rural666/xianguang-fpga-instrument/设计说明与生成脚本/弦光_界面设计说明.md

# 弦光 · 演奏界面设计说明（800×480）

配套文件：

| 文件 | 内容 |
| --- | --- |
| `xianguang_v6.html` | 设计源文件。直接打开是待机画面，网址后加 `#play` 是演奏画面 |
| `弦光_v6_待机_800x480.png` | 待机状态定稿 |
| `弦光_v6_演奏_800x480.png` | 演奏状态定稿（示例和弦 F 大七和弦） |
| `xianguang_v5.html` / `弦光_v5_*.png` | 上一版（正弦波振动），保留作对比 |

---

## 一、设计理念

### 1. 名字就是画面

"弦光"两个字本身就是设计方案：一根弦，发光。所以画面正中横着一根弦，它就是产品的名字，也是画面里唯一的视觉符号。不做和名字无关的装饰——这也是上一版（v3）的问题：那版的角标、内框、镂空数字、开关、音量柱，每一项单看都成立，合起来却是一套可以套在任何产品上的通用黑金模板，跟"弦光"没有关系。

### 2. 一个焦点，其余全部退让

整幅画面只有两个亮的东西：**弦**，和**被按下的琴键**。标题、参数、琴键音名都用暖灰，明度刻意压低。观众第一眼看弦，第二眼看琴键，不需要第三眼。

判断标准：如果一个元素去掉之后画面没有变差，它就不该存在。v3 到 v4 删掉的东西比增加的多，这是刻意的。

### 3. 金色是贵金属

金色（`#d8bd86`）只出现在三个地方：弦、和弦音名、按下的琴键。其余全部是暖灰的四个明度层。金色一旦铺开——标签是金色、数字是金色、键帽是金色——它就不再值钱，画面也就失去了贵气。稀缺性是高级感最便宜的来源。

### 4. 层次来自排版，不来自装饰

不用分割框、不用色块、不用阴影卡片来区分区块，而是用**字号差**和**字距差**：

- 主角"柔和钢琴"58px 极细宋体
- 参数值 38px Bodoni 数字
- 标签 10.5px，字距 .28em
- 英文小字 9.5px，字距 .42em

字号从 58 到 9.5 跨了六倍，主次自然分明。字号差距拉大，装饰就可以全部删掉。

### 5. 用物理真实代替电子特效

振动特效做两版，是这份设计里最重要的一次判断：

- **v5（弃用）**：正弦折线。线条尖锐、起伏均匀地铺满整条弦，整条线一起抖。这是示波器、频谱条、音乐播放器的视觉语言——是"电子特效"，不是"弦"。
- **v6（采用）**：**长曝光下的一根振动弦**。真实的琴弦振动，用长曝光拍出来是柔和的"光茧"：弦在振幅两端停留时间最长，所以光茧**边缘最亮、中间通透**。被拨动的位置是一个主光茧，两侧各有一个逐渐变小的光茧（驻波节点）。

高级感的来源不是更复杂的算法，而是**换一个参照物**：从"电子设备的显示"换成"摄影和乐器本身的物理"。凡是能用真实物理现象解释的效果，都比凭空设计的特效更耐看。

### 6. 因果链必须成立

光丝从弦上垂下来，落在对应的琴键上，琴键**顶端**被这道光照亮（暖色从键顶往下衰减）。这样"手指按下 → 琴键 → 弦 → 光"是一条完整的因果链，而不是两块各自发光的装饰。做界面时反复问：这个光是从哪来的？如果答不上来，就是特效不是设计。

### 7. 待机要安静

待机画面是那根**一动不动**的弦，中间一个很淡的光点，然后是"按下琴键，开始演奏"。不闪烁、不呼吸、不放待机动画。安静本身就是高级感——产品一直在那里等着，不需要证明自己醒着。

### 8. 像素级节制

- 线一律 1px，不加 2px 边框
- 圆角只用在琴键（3px）和状态点，标题、面板、边角全部直角
- 不用发光滤镜做大面积光晕，光只出现在弦和被按的键上
- 加一层极淡的胶片颗粒（6% 不透明度，overlay 混合），消除纯色渐变的数码感

这几条都是为了让画面在 800×480 这个尺寸下不显廉价：小屏上任何一处"厚"一点，整体都会塌。

---

## 二、色彩

只有四个暖灰明度层 + 一个金色 + 一个点缀红。

| Token | HEX | 用途 | FPGA 颜色字面量 |
| --- | --- | --- | --- |
| 底 | `#0c0b0a` | 页面底色 | `24'h0c0b0a` |
| 底·渐变 | `#0e0d0c` → `#0b0a09` | 竖直渐变 | `24'h0e0d0c` / `24'h0b0a09` |
| 柔光 | `rgba(216,189,134,.10)` | 弦后 420×120 径向光 | — |
| 主文字 | `#ebe5d9` | 品牌、参数值、状态 | `24'hebe5d9` |
| 标题 | `#f2ede3` | "柔和钢琴" | `24'hf2ede3` |
| 次文字 | `#a39b8d` | 提示语、键位、音量刻度 | `24'ha39b8d` |
| 弱文字 | `#6e675d` | 标签、英文小字 | `24'h6e675d` |
| 极弱 | `#3a3631` | 状态分隔线 | `24'h3a3631` |
| **金** | `#d8bd86` | 弦、和弦音名、按下琴键 | `24'hd8bd86` |
| 金·亮 | `#f6e4bb` | 弦的芯线、光点 | `24'hf6e4bb` |
| 红 | `#c0392b` | "实时演奏"指示点 | `24'hc0392b` |
| 毡条 | `#4a1517` | 琴键上方防尘毡 | `24'h4a1517` |

金色只允许出现在上表标注"金"的三处，其他任何地方用金色都是错的。

---

## 三、字体

| 用途 | 字体栈 | 字号 | 字距 |
| --- | --- | --- | --- |
| 标题「柔和钢琴」 | Noto Serif SC ExtraLight | 58px | .04em |
| 参数值（100 / 4） | Bodoni MT | 38px | 0 |
| 「关闭」 | Noto Serif SC Light | 25px | .08em |
| 标签（音量/八度/姿态） | Noto Serif SC | 10.5px | .28em |
| 品牌「弦光」 | Noto Serif SC | 17px | .24em |
| 英文小字 | Garamond | 9.5px | .42em |
| 音名（C4 / F♯4） | Bodoni MT | 13.5 / 9.5px | 0 |
| 键位（A / W） | Garamond | 9.5 / 8.5px | .06em |

**落到 HDMI 上要注意**：现在工程里 `assets/font8x16.hex` 是 8×16 点阵，只能满足小字级；标题 58px 需要另做点阵。

建议：

- 标签、键位、底栏继续用现成的 8×16 字模
- 标题「柔和钢琴」单独做一套 56×56 或 64×64 点阵（4 个汉字 1bpp = 56×56×4/8 = 1568 字节，很小）
- 参数值 100 / 4 用 32×48 数字点阵，10 个字形
- 「音色」「音量」「八度」「姿态」「关闭」「空间 · 开」等固定文案已经烘焙在 `assets/scene_text.hex`（1840 字节，纯 ASCII 文本 ROM），需要按新排版重新生成

---

## 四、版面（800×480 精确坐标）

基准：左右边距 48px，底栏距底 20px，键盘距顶 290px。

```
(0,0)                                                 (800,0)
 ┌───────────────────────────────────────────────────────┐
 │  弦光 XIAN GUANG            等待弹奏 ── ● 实时演奏 ⋯  │  y 26–54
 │                                                       │
 │  音色 01              音量        八度        姿态    │  y 84
 │  柔和钢琴             100%          4         关闭    │  y 98–156
 │  SOFT PIANO                 ───   C4 — B5   空间 · 开 │  y 174
 │                                                       │
 │          [ 和弦行 / 提示语 ]                          │  y 220–240
 │  ├───────────────── 弦 y258 ─────────────────┤       │
 │  ┃ 光丝×N      光丝只落在按下的键上                   │  y 262–292
 │  │  ┌─────────────────────────────────────────┐      │
 │  │  │▮▮ ▯ ▯▮▮ ▯ ▯▮▮ ▯ ▯▮▮ ▯ ▯▮▮ ▯ ▯▮▮ ▯ ▯▮▮│  14 白键 │  y 290–420
 │  │  └─────────────────────────────────────────┘      │
 │  1–8 音色    F2 试听    F5 音量复位    Esc 静音        │  y 440–460
 └───────────────────────────────────────────────────────┘
```

| 区块 | 位置（x / y） | 尺寸 | 说明 |
| --- | --- | --- | --- |
| 顶栏 | 48 → 756 / 26 | 708 × 28 | 左右两端对齐 |
| 品牌「弦光」 | 48 / 基线 44 | — | 17px，字距 .24em |
| 「XIAN GUANG」 | 紧接品牌右侧 14px | — | 9.5px，字距 .42em |
| 「等待弹奏」 | 右起，距「实时演奏」14px | — | 中间 18×1px 分隔线 |
| 「实时演奏」+ 红点 | 右起 | 点 5px | 与文案间距 8px |
| 「···」按钮 | 距右端 44px | 28 × 28 圆 | 底 `rgba(255,255,255,.035)` |
| 音色标签 | 48 / 84 | — | 「音色」+ 斜体数字「01」 |
| 标题 | 48 / 98 → 156 | 58px | 顶对齐 |
| 「SOFT PIANO」 | 48 / 174 | — | 字距 .52em |
| 参数区 | 右端 48 起，向左 | 294 宽 | 三列 118 / 92 / 84 |
| 参数标签行 | — / 84 | — | 与音色标签同一水平线 |
| 参数值行 | — / 98 → 156 | 38px | 与标题同一水平线 |
| 参数脚注行 | — / 174 | — | 与英文小字同一水平线 |
| 和弦行 / 提示语 | 0 → 800 / 220 | 居中 | 待机与演奏共用此行 |
| 弦 | 48 → 752 / 258 | 704 × 1 | 两端 46px 渐隐 |
| 弦码刻度 | 48 / 752 / 254 | 1 × 9 | 极弱色 |
| 振动区画布 | 48 / 223 | 704 × 70 | 弦在画布内基线 y=35 |
| 光丝 | 对应键中心 / 262 | 1 × 30 | 底部有 19×6 椭圆光斑 |
| 键盘 | 48 / 290 | 704 × 130 | 白键宽 = 704 ÷ 14 ≈ 50.29px |
| 毡条 | 48 / 290 | 704 × 2 | `#4a1517` |
| 琴键顶沿 | 48 / 284 | 704 × 6 | 略宽 6px，琴箱顶板 |
| 黑键 | 白键边界 / 290 | 白键宽 ×.6 = 30.2，高 58% = 75px | 居中于白键交界 |
| 音名 | 白键居中 / 底 25 | 13.5px | 黑键居中 / 底 21，9.5px |
| 键位 | 白键居中 / 底 10 | 9.5px | 黑键居中 / 底 8，8.5px |
| 底栏 | 48 → 752 / 底 20 | — | 四项均分，`space-between` |

**换算到其他分辨率**：按 800×480 设计。若板载仍是 640×360 的有效区，横向 ×0.8、纵向 ×0.75（1px 线宽保持不变），键盘高度 130 → 98，弦位置 258 → 194。

---

## 五、状态

| 元素 | 待机 | 演奏 |
| --- | --- | --- |
| 弦 | 直线，中央光点，1px 渐隐线 | 被按处起振（见第六节） |
| 弦行文字 | 「按下琴键，开始演奏」11.5px，字距 .42em | 和弦信息行（见下） |
| 背后柔光 | 420×120 @ (50%, 250) | 460×120 @ (47%, 258) 略向弦偏 |
| 琴键 | 白键顶部 9% 处一道暗影（琴盖投影） | 按下的键顶端暖光，底部 2px 金线 |
| 红点 | 常亮 | 常亮 |

**和弦行**（演奏时替换提示语，居中，四段用 14×1px 细线分隔）：

```
F 大七和弦   F MAJOR 7  ──  F4 · A4 · C5 · E5  ──  复音 4
   13px         9.5px          13px Bodoni 斜体        10.5px
```

- 中文和弦名：主文字色
- 英文名：弱文字色，字距 .42em
- 音名串：金色，Bodoni 斜体，音名之间用 `·` 分隔
- 复音数：弱文字色，数字用次文字色。**这一项与 HDMI 工程现有画面一致**，保留。
- 若不想在和弦行显示复音数，把「复音」段整体删除即可，其余三段位置不受影响（左对齐到弦中心）。

---

## 六、振动弦的算法

### 6.1 模型

每个按下的音对应一段**驻波**。符号：

- `s`：该音距 C4 的半音数（C4 = 0 … B5 = 23）
- `x_n`：该音对应琴键的中心横坐标
- `j`：按下顺序（0 起），`order` 为同时按下的音数
- `x`：画布内横坐标，`Y = 35` 为弦的静止位置

```
半波长   h_n = 40 · 2^(−s/24)                      音越高，光茧越窄
振幅     A_n = 12.5 · (1 − s/42) · (0.86 + 0.14·(j+1)/order)
包络     u = (x − x_n) / h_n
         g_n(x) = exp(−u²)                        每个音的驻波只在自己附近
相位差   δ_n = 1.37 · j                            先按的音略微失相
位移     disp(x,φ) = Σ_n A_n · g_n(x) · [ cos(φ+δ_n)·cos(πu)
                                        + 0.2·cos(2φ+1.7δ_n)·cos(2πu+0.6) ]
边缘渐隐 disp'(x,φ) = disp(x,φ) · min(1, x/46, (704−x)/46)
```

第二项是弱的二次谐波，让光茧两端略微不对称，避免过于数学化。

### 6.2 绘制（长曝光）

关键在于**不画函数图像，而是叠画很多个相位**，让弦在振幅两端的停留时间自然累积成亮度：

```js
const K = 64;                                  // 相位数量
for (let k = 0; k < K; k++) {
  const φ = 2 * Math.PI * k / K;
  // 每条线：1px 宽，透明度 0.06，两端 46px 渐隐
  描线(x → Y + disp'(x, φ));
}
// 另加 16 条 2.2px 宽、blur(5px)、透明度 0.07 的粗线做柔光
// 另加 2 条沿 ±包络的 0.6px、透明度 0.22 的轮廓线，让光茧边缘清晰
```

透明度乘 K 之后总能量约等于一条实线的 4 倍，所以单条线必须很淡（0.06）。相位越多越顺滑，64 是个好平衡。

**叠加顺序**：先画柔光层，再画 64 条发丝线，最后画两条包络轮廓。混合模式用 `lighter`（加法）。

### 6.3 音符参数对照（示例：F 大七和弦）

| 音 | s | 键中心 x（画布内） | h | A |
| --- | --- | --- | --- | --- |
| F4 | 5 | 176.0 | 34.7 | 9.85 |
| A4 | 9 | 276.6 | 30.8 | 9.13 |
| C5 | 12 | 377.1 | 28.3 | 8.62 |
| E5 | 16 | 477.7 | 25.2 | 7.74 |

从表里能直接看出设计意图：**F4 是舒展的大结，E5 是紧致的小结**——光茧大小与音高一一对应，观众不看音名也能感受到音区。

### 6.4 落到 FPGA

`xianguang_v6.html` 是**参考实现和离线渲染器**（可以用它导出任意和弦的定稿图）。板载实现建议走下面两条路之一。

**方案 A：解析式逐像素计算（省内存，推荐）**

不需要帧缓冲。利用一个性质：**画面的振动区只有 704×70，而且同一列上包络 `E(x) = Σ A_n·g_n(x)` 相同**。所以：

1. 每列只算一次 `E(x)`（4 个音 × 一次 `g_n` 查表），存进一行列缓存
2. 逐像素只做：`d = |y − 35| × recip(E(x))`，再用 `d` 查一条 256 项的**相位密度曲线表** `p(d)`
3. `p(d)` 就是长曝光的密度分布——`d≈1`（包络边缘）最亮，`d≈0`（中轴）最暗。这张表在电脑上用 6.2 的 JS 跑一次导出即可

代价估算：每像素约 5～6 个操作加两次查表（倒数表 + 密度表），加 2～3 级流水线即可。比现在 `studio_scene.v` 里逐像素比较的复杂度只高一点。

其中 `g_n(x) = exp(−u²)` 建议换成 `cos²(πu/2)`（|u| < 1 时），视觉上几乎看不出差别，但只需要一次 `cos` 查表：

```
g_n(x) ≈ cos²(π·u/2),  |u| < 1
```

**方案 B：精灵图加法混合（最省算力）**

在电脑上用 6.2 的 JS 把 12 个音级的光茧各渲染成一张 96×64、4bpp 的精灵（每张 3KB，共 36KB），存进 BSRAM。板载只做：

1. 对每个按下的音，按 `x_n` 取对应精灵
2. 在 704×70 的振动区里累加（加法混合，饱和）
3. 边缘 46px 用现成的渐隐系数乘一次

每像素 4 次 BRAM 读 + 4 次加法。Tang Nano 20K 的 BSRAM 够用，但会吃掉相当一部分，需要你按现有资源权衡。

**不要做的**：直接用正弦函数画折线（v5 的做法）。它是"电子特效"的视觉语言，和"弦"无关；而且整条线一起抖，没有主次。

### 6.5 琴键被照亮

按下时不要整体提亮，而是**光从上方照下来**：

```css
.wk.on {
  background:
    radial-gradient(95% 52% at 50% 0%, rgba(238,198,128,.62), rgba(238,198,128,0) 100%),
    linear-gradient(180deg,#83765f 0%,#cfc0a2 9%,#e5d9c3 40%,#ebe2d0 88%,#d9cdb8 96%,#c0b39b 100%);
  box-shadow: 0 2px 0 rgba(226,184,108,.9) inset;   /* 键底一道金线 */
}
```

FPGA 上等价于：在琴键矩形内，按 `(键顶到当前行) / 键高` 查一条 16 项的暖色衰减表，再和键的底色做 1 次线性插值。黑键同理但幅度只有白键的一半左右（`.34` 对 `.62`）。

---

## 七、落到工程上的改动清单

按你工程现有的结构（`studio_scene.v` 逐像素生成、`assets/*.hex` 存字模和文案）：

| 项目 | 现状 | 需要做的 |
| --- | --- | --- |
| 分辨率 | 640×360 有效区（640×480 输出，上下留黑） | 改 800×480，或按第四节的系数把版面缩回去 |
| 键盘 | 现有键数与布局 | 改为 24 键（14 白 + 10 黑），键宽 = 画面宽 ÷ 14 |
| 文案 ROM | `assets/scene_text.hex`，1840 字节，含 "XIAN GUANG / FPGA PERFORMANCE SYSTEM" | 按新排版重新生成（标题、标签、和弦行、底栏） |
| 品牌字标 | `assets/brand64x32.hex`，64×32 1bpp | 改为「弦光 / XIAN GUANG」字标 |
| 字模 | `assets/font8x16.hex`，2048 字节 = 128 个 8×16 字模 | 保留给小字（标签、键位、底栏）；标题另做 56×56 汉字点阵（4 字 1bpp 共 1568 字节），参数值做 32×48 数字点阵（10 字形） |
| 音色标签 | `assets/timbre_text.hex`，128 字节 | 文案沿用，注意与「柔和钢琴 / SOFT PIANO」一致 |
| 调色板 | `studio_scene.v` 内 24 位字面量（`24'h08121e` 等） | 换成第二节的表 |
| 振动 | 现有波形取自扬声器 PCM | 换成本节 6.4 的方案 A 或 B |

---

## 八、两处必须确认

1. **上八度（C5–B5）的实际按键**
   我在工程里只找到下八度：`A W S E D F T G Y H U J`（`tang_studio_v09/使用说明.md` 第 13 行）。上八度的键位没有找到，设计图里暂时标成 **⇧ + 同键**（⇧A、⇧W……）。请提供真实键位，我重新出图。若最终不显示键位，直接把 `.wk .k` / `.bk .k` 两个元素删掉即可，版面不受影响。

2. **是否显示和弦行**
   和弦名（「F 大七和弦 / F MAJOR 7」）需要和弦识别逻辑，如果工程里没有，可以只显示音名串「F4 · A4 · C5 · E5」和复音数，把前两段删掉，同样不受影响。
