rural666/xianguang-fpga-instrument/docs/legacy_scripts/README.md

# 原包中的参考脚本

这些脚本与原包相同，因依赖未提供的controller、testdata或历史工作目录而归档。它们不是本仓库的可直接运行入口。需要对应原工程配套文件后才应使用。

当前构建入口为fpga_source/scripts/build_fpga.ps1；仿真入口为fpga_source/scripts/test.ps1；完整性校验为scripts/check_project.ps1。
