rural666/xianguang-fpga-instrument/fpga_source/assets/two_rows_idle.png

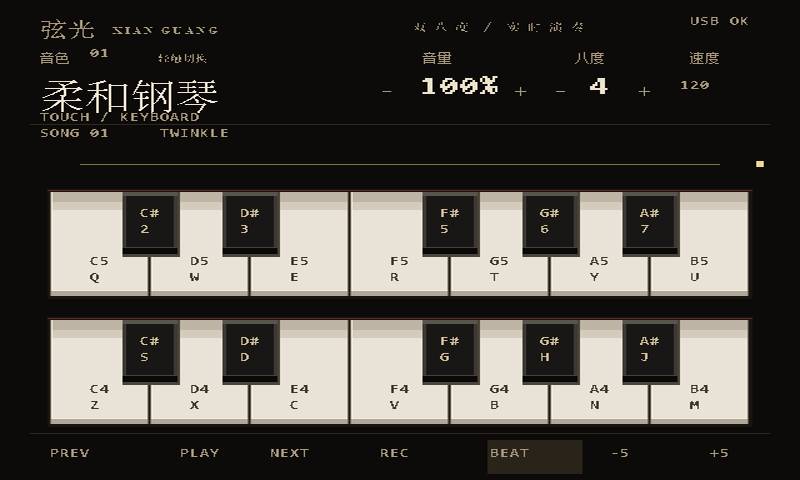
fpga_source/assets/two_rows_idle.png
