rural666/xianguang-fpga-instrument/fpga_source/assets/two_rows_play.png

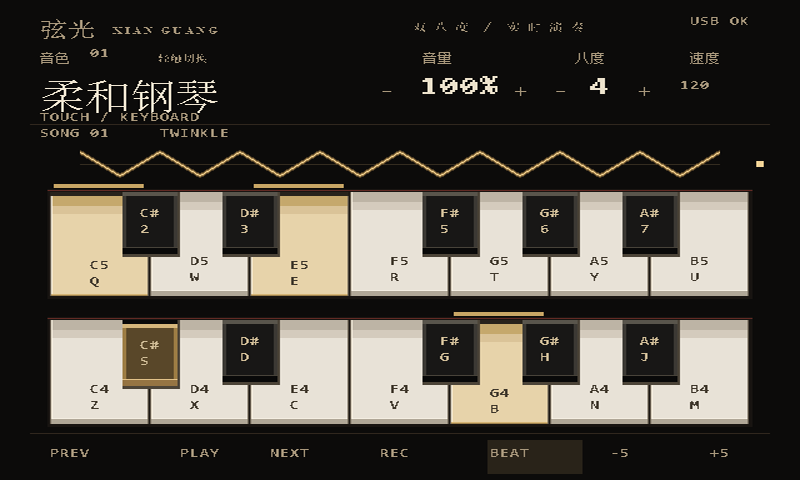
fpga_source/assets/two_rows_play.png
