rural666/xianguang-fpga-instrument/fpga_source/rtl/adpcm6_encoder.v

`default_nettype none
// Six-bit adaptive differential PCM: sign + five magnitude bits.
// Same step table as IMA, finer reconstruction levels; this is NOT standard IMA.
module adpcm6_encoder(input wire clk,rst,start,input wire signed [15:0] sample,
    output reg done,output reg [5:0] code,output reg signed [15:0] predictor,output reg [6:0] step_index);
    reg [15:0] steps[0:88];
    reg signed [15:0] held;reg [15:0] step;reg busy;
    reg signed [17:0] difference,next_predictor;
    reg [16:0] magnitude,decoded;
    integer next_index;reg [5:0] bits;
    initial $readmemh("rtl/ima_steps.hex",steps);
    always @* begin
        difference=$signed(held)-$signed(predictor);bits=0;
        if(difference<0)begin bits=32;magnitude=-difference;end else magnitude=difference;
        decoded=step>>5;
        if(magnitude>=step)begin bits=bits|16;magnitude=magnitude-step;decoded=decoded+step;end
        if(magnitude>=(step>>1))begin bits=bits|8;magnitude=magnitude-(step>>1);decoded=decoded+(step>>1);end
        if(magnitude>=(step>>2))begin bits=bits|4;magnitude=magnitude-(step>>2);decoded=decoded+(step>>2);end
        if(magnitude>=(step>>3))begin bits=bits|2;magnitude=magnitude-(step>>3);decoded=decoded+(step>>3);end
        if(magnitude>=(step>>4))begin bits=bits|1;decoded=decoded+(step>>4);end
        next_predictor=bits[5]?$signed(predictor)-$signed({1'b0,decoded}):$signed(predictor)+$signed({1'b0,decoded});
        if(next_predictor>32767)next_predictor=32767;else if(next_predictor< -32768)next_predictor=-32768;
        case(bits[4:2])
            0,1,2,3:next_index=step_index-1;4:next_index=step_index+2;
            5:next_index=step_index+4;6:next_index=step_index+6;7:next_index=step_index+8;
            default:next_index=0;
        endcase
        if(next_index<0)next_index=0;else if(next_index>88)next_index=88;
    end
    always @(posedge clk)begin
        if(rst)begin done<=0;code<=0;predictor<=0;step_index<=0;held<=0;step<=7;busy<=0;end
        else begin
            done<=0;
            if(start&&!busy)begin held<=sample;step<=steps[step_index];busy<=1;end
            else if(busy)begin predictor<=next_predictor[15:0];step_index<=next_index[6:0];code<=bits;done<=1;busy<=0;end
        end
    end
endmodule
`default_nettype wire
